dh219/pistorm/(commit log)

2022-07-12 Adding something to boot!
    [default.cfg]
2022-07-20 Bus error almost working -- able to boot a stock ROM now.
    [default.cfg]
2022-07-20 Bus error almost working: can boot a stock TOS
    [emulator.c]
2022-07-20 Recording the error address. Problems persist with the IACK cycle causing bus errors still
    [emulator.c, ps_protocol.c]
2022-07-26 Slow clock to improve stability -- mutexs not helping
    [default.cfg]
2022-08-02 Using RESET line to optimise bus error check -- bus accesses still only at 50%, however.
    [emulator.c, ps_protocol.c]
2022-08-02 Using RESET to optimise bus error handling (no ST->PI reset ATM)
    [pistorm.v]
2022-08-02 Nasty hack to compare IPL just before invoking the interrupt handler
2022-08-04 Full speed write, but only half speed read. Nasty hack that ignores write bus errors -- needs a proper looking at
    [emulator.c, ps_protocol.c]
2022-10-08 Revert "S0-7 by the book seems to be working. Slow as molasses. Work back from here"
    This reverts commit 292b3f12ce58afd26f34c23d522de0aacc3afeb7.
    [pistorm.v]
2022-10-08 Revert "Deliberately backtracking to a more 'by the book' 68k state machine. Slow, but a starting point."
    This reverts commit cd1fd31838e045c6d0f76dc8ce47c3b3187d6504.
    [pistorm.v]
2022-10-15 Bus error properly handled for reads and writes plus optimisations
    [ps_protocol.c]
2022-10-21 Optimising write terminate and read latch, but cannot optimise read terminate any more -- irksome. Still stuck at 2.5MB/s on read.
    [pistorm.v]
2022-10-22 Realised I had a redundant op_rw termination check. Removed and seems stable at 2.5/3.7. Working next on a new bus error idea.
    [pistorm.v]
2022-10-22 Working towards doing away with the reset-on-buserr hack. Returning special code on read bus errors
    [pistorm.v]
2022-10-22 Only checking bus errors on read -- looking for special 0xBE12 code.
    [ps_protocol.c]
2022-10-23 Adding support for testing the ST's memory a la buptest
2022-10-30 This appears to be the limit of shortening the read cycle on the ST, but it has no material effect to the read speed. The rest would have to come from a faster Pi, or software optimisation, I think.
    [pistorm.v]
2022-11-28 Adding the current firmware bitstream, to avoid confusion
2022-12-17 Fixed data latching issue -- no speed attempt, but correcting a flipflop/latch mix up
    [pistorm.v]
2022-12-28 Working in no-DMA mode with my flip-flop board and a pi 3A
    [pistorm.v]
2022-12-28 Working on my flipflop board with nodma.
    [default.cfg]
2023-01-07 Going back to amiga state machine and modding again to try to harmonise latch/flipflop logic. No bus arb yet.
    [pistorm.v]
2023-01-07 Fixing up some ataritest issues
    [ataritest.c]
2023-01-07 Working with corrected autovectored IACK on the flipflop board
    [default.cfg]
2023-01-07 Correcting typo in rom declaration
    [default.cfg]
2023-01-11 Introducing support for reset on ST variant.
    [pistorm.v]
2023-01-11 Emulator-side support for reset on ST.
    [default.cfg]
2023-08-09 Started work on an STE pistorm
    [pistorm-ste.kicad_pcb, pistorm-ste.sch]
2023-08-11 Schematic tentatively finished
    [pistorm-ste.sch]
2023-08-15 Started a layout
    [pistorm-ste.kicad_pcb, pistorm-ste.sch]
2023-08-18 Upgrade to Kicad6 happened. Need to test measurements before routing as don't know about layout yet.
    [pistorm-ste.kicad_pcb, pistorm-ste.kicad_sch]
2023-08-20 Trying a different layout
    [pistorm-ste.kicad_pcb]
2023-08-24 Working on tightening the gap to the two level shifters and the CPU pins
    [pistorm-ste.kicad_pcb]
2023-08-29 squishing up to avoid post
    [pistorm-ste.kicad_pcb]
2023-08-29 Started routeing address lines
    [pistorm-ste.kicad_pcb]
2023-09-01 Most major connections done. South-side CPLD to work on next
    [pistorm-ste.kicad_pcb, pistorm-ste.kicad_sch]
2023-09-01 Primary routeing completed. Many DRC errors.
    [pistorm-ste.kicad_pcb, pistorm-ste.kicad_sch]
2023-09-05 Routing complete and passing DRC. Query PLCC socket alignment. Will change to a single footprint.
    [pistorm-ste.kicad_pcb, pistorm-ste.kicad_sch]
2023-09-05 Changing separate pin headers for PLCC plug footprint. DRC not passing yet
    [pistorm-ste.kicad_pcb]
2023-09-05 Passing DRC. Fixed 3d model issue with the plug footprint.
    [pistorm-ste.kicad_pcb, pistorm-ste.kicad_sch]
2023-09-06 Adding a support post hole.
    [pistorm-ste.kicad_pcb]
2023-09-07 Squeezed down to 100mm width to fit in the PCBWay cheaper bracket
    [pistorm-ste.kicad_pcb]
2023-09-07 Resized vias to hit another PCBWay price break
    [pistorm-ste.kicad_pcb]
